lisboacesar/detector-de-gas/evidencias/teste2_exposicoes/relatorio.md

> DADOS SIMULADOS: gerados por ferramentas/simular_ensaios.py a partir dos parametros do prototipo e processados pelo relatorio.py (Secao 5.4 do paper).

# Relatório do detector de gás: teste2_exposicoes

Período: 28/10/2026 15:02:59 a 28/10/2026 16:01:59 (59,0 min)

## Transmissão e armazenamento

| Métrica | Valor |
| --- | --- |
| Mensagens gravadas no banco | 3523 |
| Mensagens esperadas pelo seq | 3570 |
| Taxa de entrega pelo seq | 98,7% |
| Mensagens esperadas pelo tempo (1 a cada 1 s) | 3540 |
| Cobertura pelo tempo | 99,5% |
| Lacunas no seq | 25 (total de 47 mensagens) |
| Mensagens duplicadas | 0 |
| Reinícios da placa (seq voltou a 0) | 0 |

## Atraso entre a leitura no ESP32 e a chegada ao coletor

Depende dos relógios do ESP32 (NTP) e do computador estarem sincronizados.

| Métrica | Valor |
| --- | --- |
| Médio | 0,37 s |
| Mediana | 0,33 s |
| 95% das mensagens abaixo de | 0,69 s |
| Máximo | 2,27 s |

## Leituras do sensor

| Métrica | Valor |
| --- | --- |
| Nível mínimo / médio / máximo | 1409 / 1786 / 3950 |
| Limite(s) usado(s) | 2091, 2093, 2094, 2095, 2096, 2097, 2098, 2099, 2100, 2101, 2102, 2103, 2104, 2105, 2106, 2107, 2108, 2109, 2110 |
| Episódios de alerta | 20 |

| # | Início | Fim | Duração | Pico | Limite |
| --- | --- | --- | --- | --- | --- |
| 1 | 28/10/2026 15:05:02 | 28/10/2026 15:05:35 | 33,00 s | 3943 | 2100 |
| 2 | 28/10/2026 15:07:31 | 28/10/2026 15:08:06 | 35,01 s | 3900 | 2103 |
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
| 28/10/2026 15:49:27 | 6710 | 6713 | 2 |
| 28/10/2026 15:54:16 | 7002 | 7004 | 1 |
| 28/10/2026 15:54:18 | 7004 | 7007 | 2 |
| 28/10/2026 16:01:31 | 7439 | 7442 | 2 |
| 28/10/2026 16:01:37 | 7445 | 7450 | 4 |

Arquivos: leituras.csv, eventos.csv, grafico.png
