lisboacesar/detector-de-gas/evidencias/prints/aplicativo_leituras.png

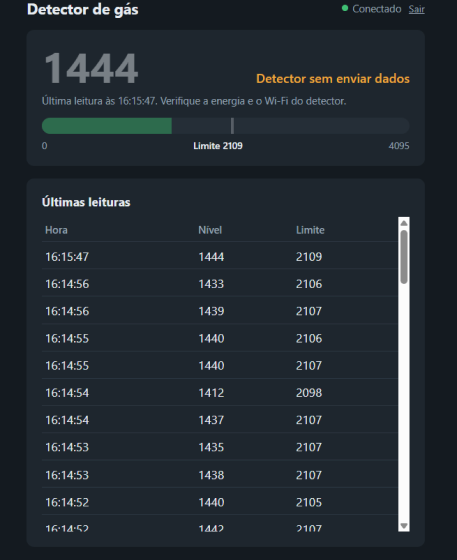
evidencias/prints/aplicativo_leituras.png
