lisboacesar/detector-de-gas/evidencias/prints/aplicativo_login.png

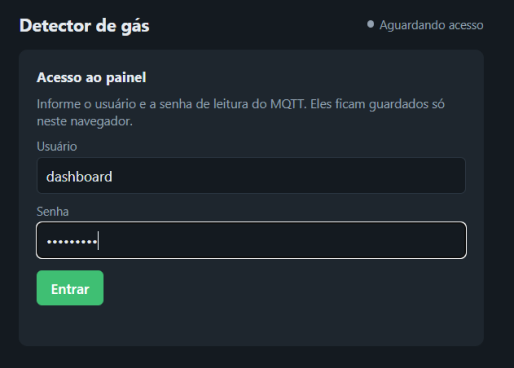
evidencias/prints/aplicativo_login.png
