lisboacesar/detector-de-gas/evidencias/prints/montagem_fritzing.png

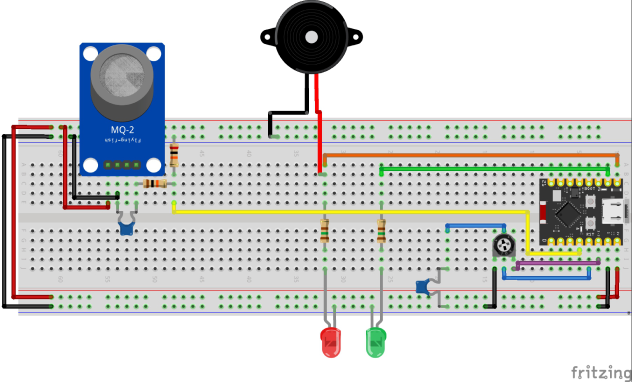
evidencias/prints/montagem_fritzing.png
