lisboacesar/detector-de-gas/evidencias/prints/prototipo_protoboard.png

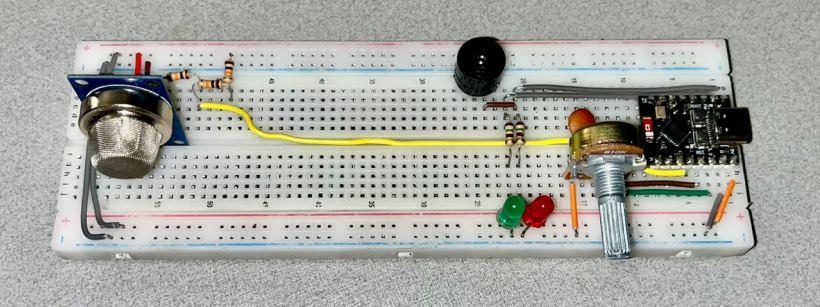
evidencias/prints/prototipo_protoboard.png
