lisboacesar/detector-de-gas/evidencias/teste_seguranca_20261028_1622.txt

# DADOS SIMULADOS: resultado esperado do teste_seguranca.py com as regras configuradas no EMQX Cloud (sem acesso anonimo, usuario de leitura sem permissao de publicar). Secao 5.4 do paper.
Teste de seguranca do broker z2d90268.ala.us-east-1.emqxsl.com:8883
Data: 28/10/2026 16:22:41

1. Conectar sem usuario e senha
   Resultado: RECUSADO (esperado)
   Detalhe do broker: Bad user name or password

2. Conectar com o usuario 'dashboard' e senha errada
   Resultado: RECUSADO (esperado)
   Detalhe do broker: Bad user name or password

3. Publicar em detector-gas/teste-seguranca com o usuario de leitura 'dashboard'
   Resultado: RECUSADO (esperado)
   Detalhe do broker: PUBACK: Not authorized; mensagem nao chegou ao topico; conexao mantida

Resumo: 3 de 3 tentativas indevidas recusadas.
