lisboacesar/detector-de-gas/evidencias/teste1_ar_limpo/leituras.csv

hora_leitura | hora_recebida | atraso_ms | dispositivo | seq | nivel | limite | critico
28/10/2026 14:00:00 | 28/10/2026 14:00:00 | 337 | detector-01 | 130 | 1436 | 2104 | 0
28/10/2026 14:00:01 | 28/10/2026 14:00:01 | 220 | detector-01 | 131 | 1440 | 2104 | 0
28/10/2026 14:00:02 | 28/10/2026 14:00:02 | 335 | detector-01 | 132 | 1434 | 2103 | 0
28/10/2026 14:00:03 | 28/10/2026 14:00:03 | 441 | detector-01 | 133 | 1446 | 2102 | 0
28/10/2026 14:00:04 | 28/10/2026 14:00:04 | 331 | detector-01 | 134 | 1437 | 2104 | 0
28/10/2026 14:00:05 | 28/10/2026 14:00:05 | 286 | detector-01 | 135 | 1436 | 2104 | 0
28/10/2026 14:00:06 | 28/10/2026 14:00:06 | 377 | detector-01 | 136 | 1428 | 2102 | 0
28/10/2026 14:00:07 | 28/10/2026 14:00:07 | 242 | detector-01 | 137 | 1432 | 2100 | 0
28/10/2026 14:00:08 | 28/10/2026 14:00:08 | 369 | detector-01 | 138 | 1444 | 2100 | 0
28/10/2026 14:00:09 | 28/10/2026 14:00:09 | 312 | detector-01 | 139 | 1433 | 2102 | 0
28/10/2026 14:00:12 | 28/10/2026 14:00:12 | 463 | detector-01 | 142 | 1434 | 2100 | 0
28/10/2026 14:00:13 | 28/10/2026 14:00:13 | 550 | detector-01 | 143 | 1439 | 2100 | 0
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
