lisboacesar/detector-de-gas/evidencias/teste2_exposicoes/leituras.csv

hora_leitura | hora_recebida | atraso_ms | dispositivo | seq | nivel | limite | critico
28/10/2026 15:02:59 | 28/10/2026 15:03:00 | 429 | detector-01 | 3898 | 1427 | 2097 | 0
28/10/2026 15:03:00 | 28/10/2026 15:03:00 | 241 | detector-01 | 3899 | 1426 | 2100 | 0
28/10/2026 15:03:01 | 28/10/2026 15:03:02 | 557 | detector-01 | 3900 | 1420 | 2103 | 0
28/10/2026 15:03:02 | 28/10/2026 15:03:02 | 159 | detector-01 | 3901 | 1424 | 2105 | 0
28/10/2026 15:03:03 | 28/10/2026 15:03:03 | 247 | detector-01 | 3902 | 1428 | 2106 | 0
28/10/2026 15:03:04 | 28/10/2026 15:03:05 | 462 | detector-01 | 3903 | 1430 | 2100 | 0
28/10/2026 15:03:05 | 28/10/2026 15:03:05 | 358 | detector-01 | 3904 | 1411 | 2105 | 0
28/10/2026 15:03:06 | 28/10/2026 15:03:06 | 374 | detector-01 | 3905 | 1420 | 2100 | 0
28/10/2026 15:03:07 | 28/10/2026 15:03:07 | 263 | detector-01 | 3906 | 1424 | 2104 | 0
28/10/2026 15:03:08 | 28/10/2026 15:03:08 | 387 | detector-01 | 3907 | 1424 | 2103 | 0
28/10/2026 15:03:09 | 28/10/2026 15:03:10 | 515 | detector-01 | 3908 | 1427 | 2098 | 0
28/10/2026 15:03:10 | 28/10/2026 15:03:10 | 304 | detector-01 | 3909 | 1427 | 2104 | 0
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
