lisboacesar/detector-de-gas/evidencias/teste5_autonomia/eventos.csv

hora | tipo | valor
28/10/2026 16:08:45 | status_detector | offline
28/10/2026 16:11:09 | status_detector | online
