lisboacesar/detector-de-gas/evidencias/teste5_autonomia/leituras.csv

hora_leitura | hora_recebida | atraso_ms | dispositivo | seq | nivel | limite | critico
28/10/2026 16:05:00 | 28/10/2026 16:05:01 | 362 | detector-01 | 7648 | 1451 | 2104 | 0
28/10/2026 16:05:01 | 28/10/2026 16:05:02 | 275 | detector-01 | 7649 | 1448 | 2100 | 0
28/10/2026 16:05:02 | 28/10/2026 16:05:02 | 248 | detector-01 | 7650 | 1444 | 2104 | 0
28/10/2026 16:05:03 | 28/10/2026 16:05:03 | 165 | detector-01 | 7651 | 1438 | 2100 | 0
28/10/2026 16:05:04 | 28/10/2026 16:05:05 | 828 | detector-01 | 7652 | 1443 | 2098 | 0
28/10/2026 16:05:05 | 28/10/2026 16:05:06 | 491 | detector-01 | 7653 | 1448 | 2102 | 0
28/10/2026 16:05:06 | 28/10/2026 16:05:06 | 233 | detector-01 | 7654 | 1441 | 2101 | 0
28/10/2026 16:05:07 | 28/10/2026 16:05:08 | 388 | detector-01 | 7655 | 1448 | 2100 | 0
28/10/2026 16:05:08 | 28/10/2026 16:05:09 | 306 | detector-01 | 7656 | 1443 | 2104 | 0
28/10/2026 16:05:09 | 28/10/2026 16:05:10 | 343 | detector-01 | 7657 | 1446 | 2100 | 0
28/10/2026 16:05:10 | 28/10/2026 16:05:11 | 377 | detector-01 | 7658 | 1445 | 2098 | 0
28/10/2026 16:05:11 | 28/10/2026 16:05:12 | 254 | detector-01 | 7659 | 1447 | 2097 | 0
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
