lisboacesar/detector-de-gas/evidencias/teste1_ar_limpo/grafico.png

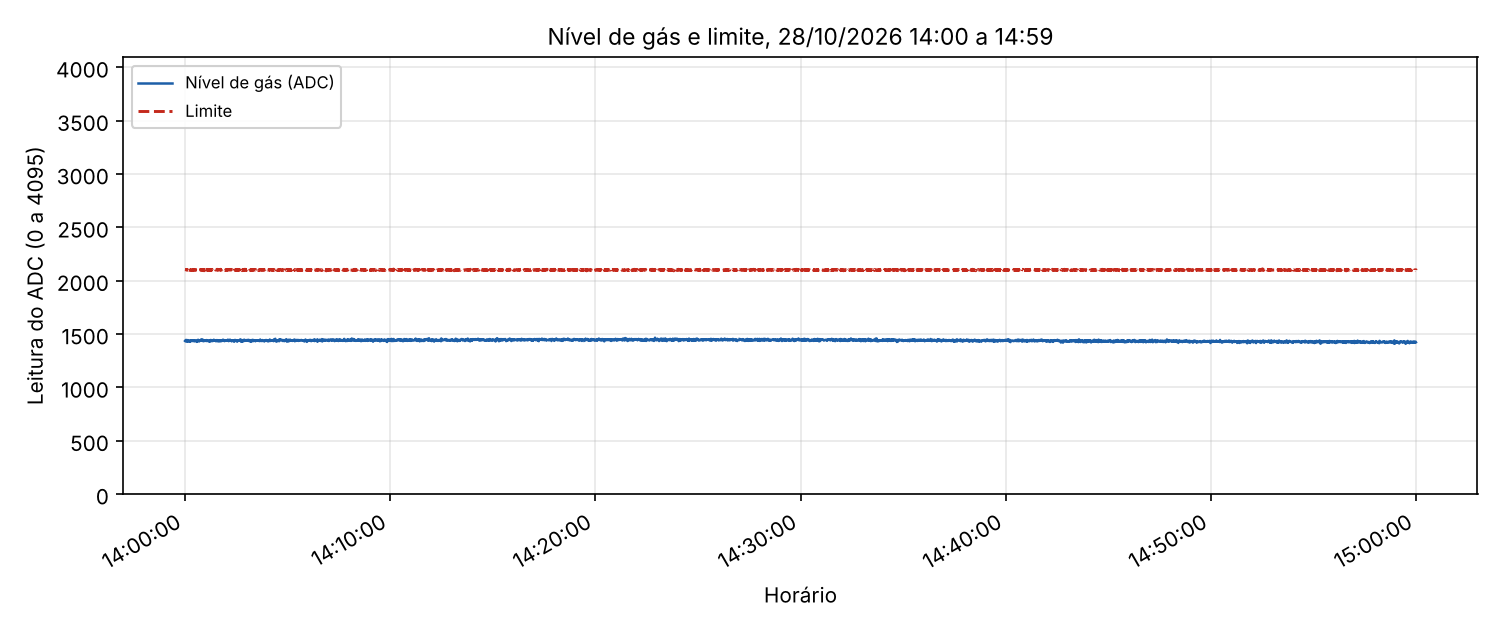
evidencias/teste1_ar_limpo/grafico.png
