lisboacesar/detector-de-gas/evidencias/teste2_exposicoes/grafico.png

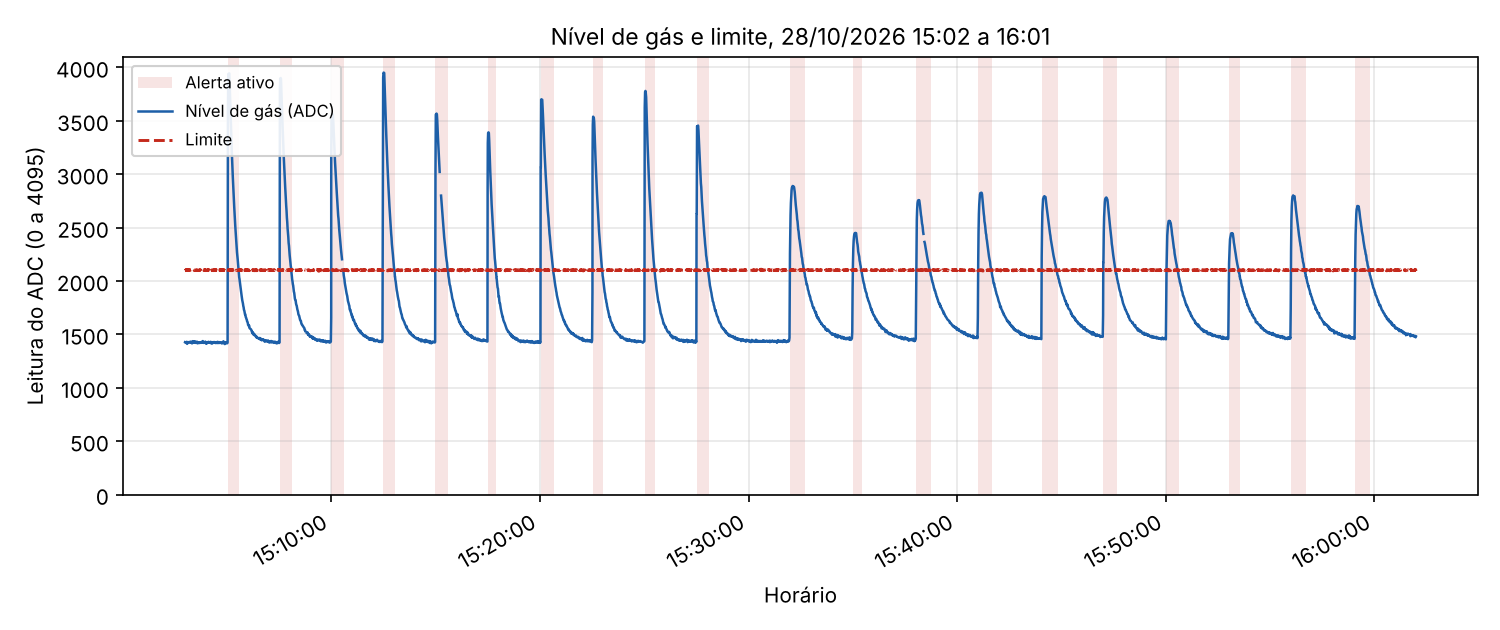
evidencias/teste2_exposicoes/grafico.png
