lisboacesar/detector-de-gas/evidencias/teste5_autonomia/grafico.png

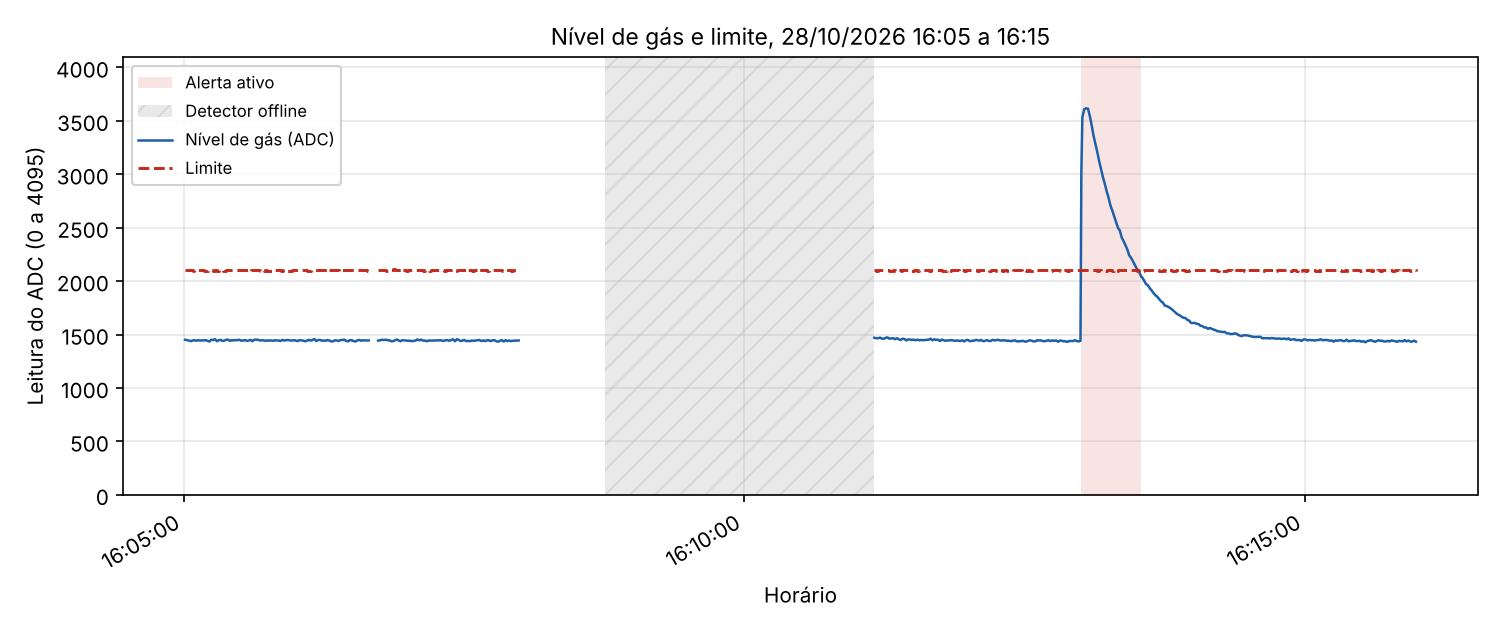
evidencias/teste5_autonomia/grafico.png
