lisboacesar/detector-de-gas/figuras/esquematico.pdf

### sensor

### alerta

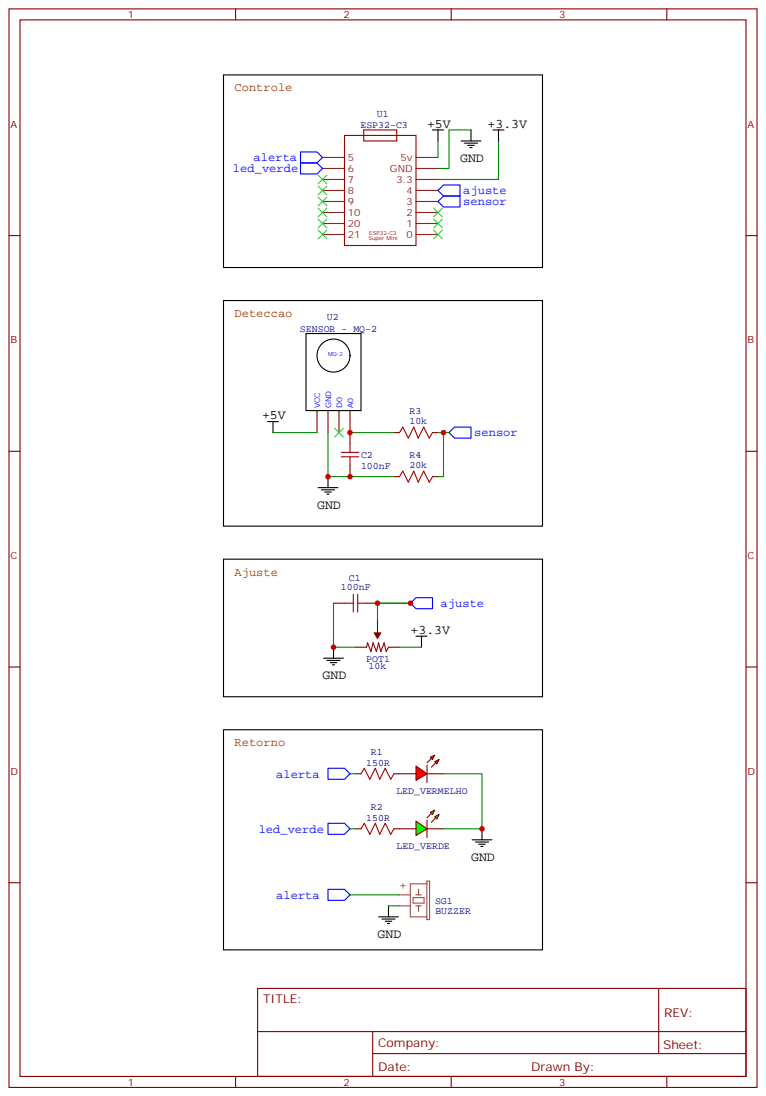
[picture p10: page 1]
