lisboacesar/detector-de-gas/(commit log)

2026-10-27 Detector de gas com ESP32-C3, MQ-2 e MQTT
2026-10-29 Evidencias provisorias dos testes
    [custo_hardware.csv, eventos.csv, leituras.csv]
2026-11-05 CI: compile firmware with arduino-cli
